growthlayer/gt-trackball/harness/gt-trackball.png

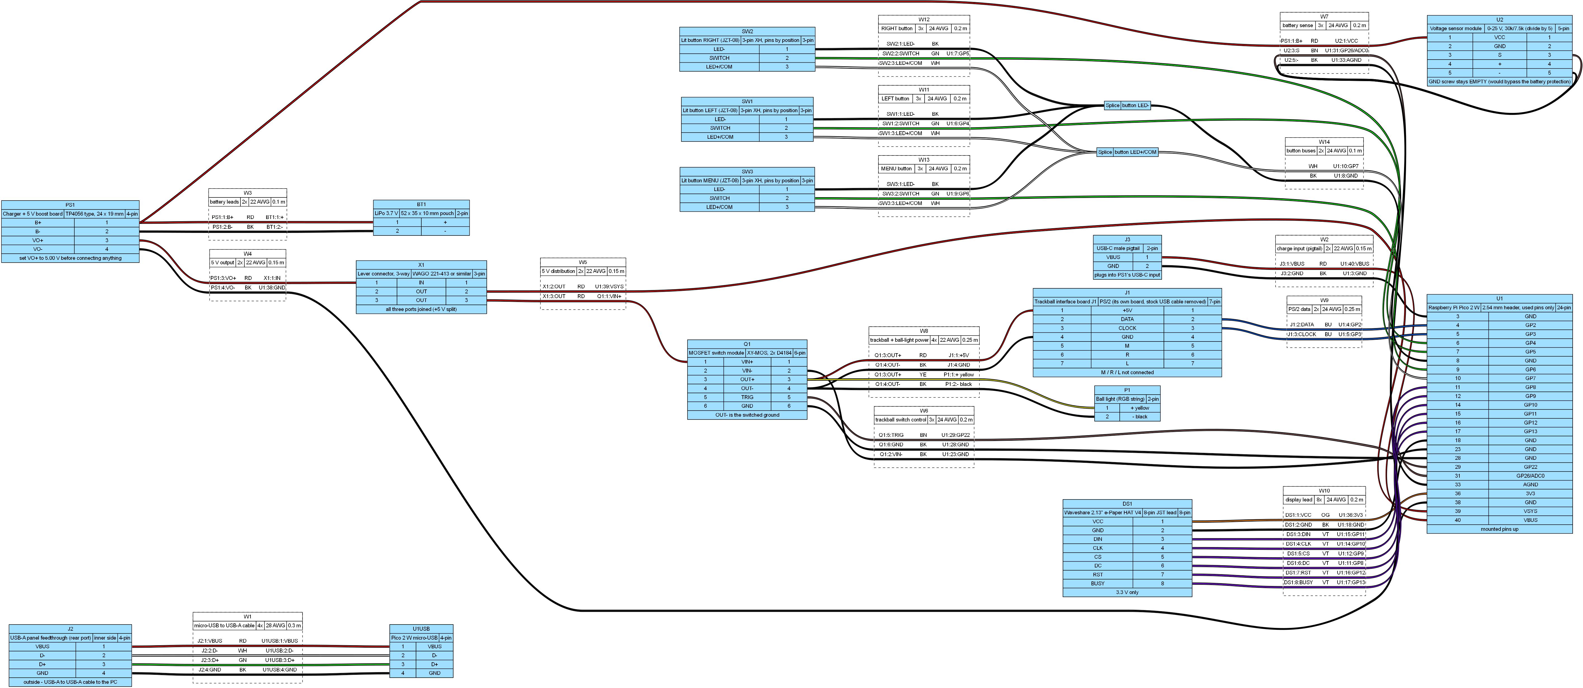
harness/gt-trackball.png
