growthlayer/gt-trackball/images/part_plate.png

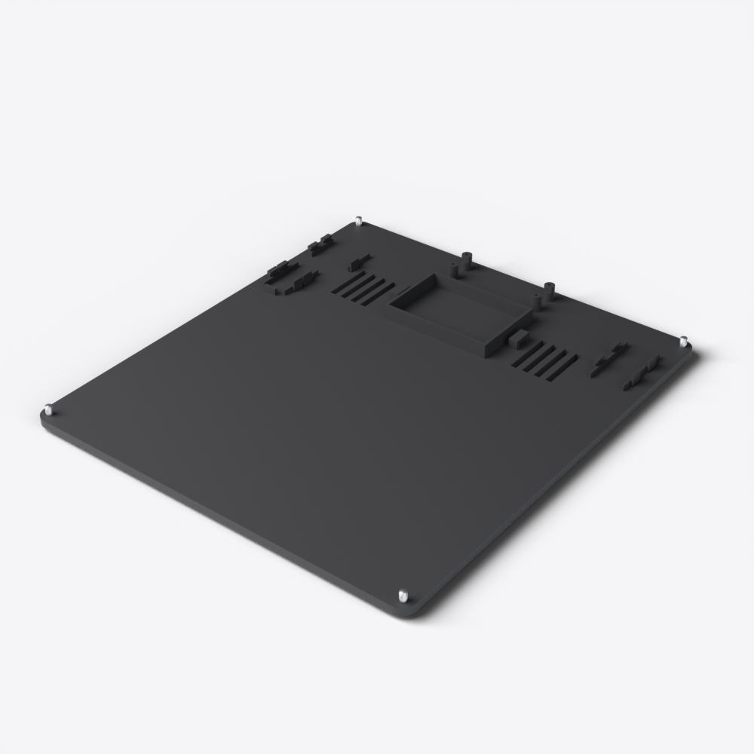
images/part_plate.png
