growthlayer/gt-trackball/images/part_shell.png

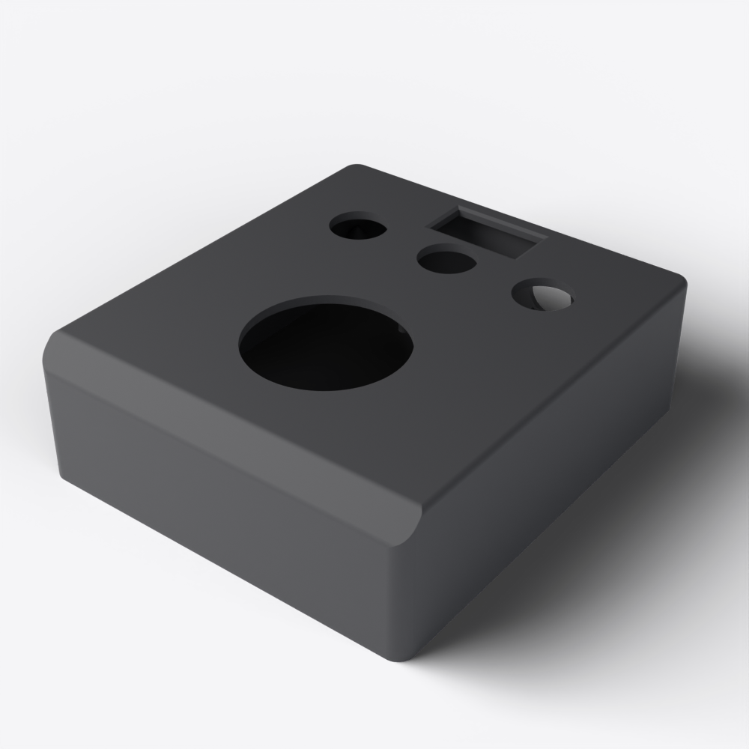
images/part_shell.png
