growthlayer/gt-trackball/print/bambu-a1/clips.3mf

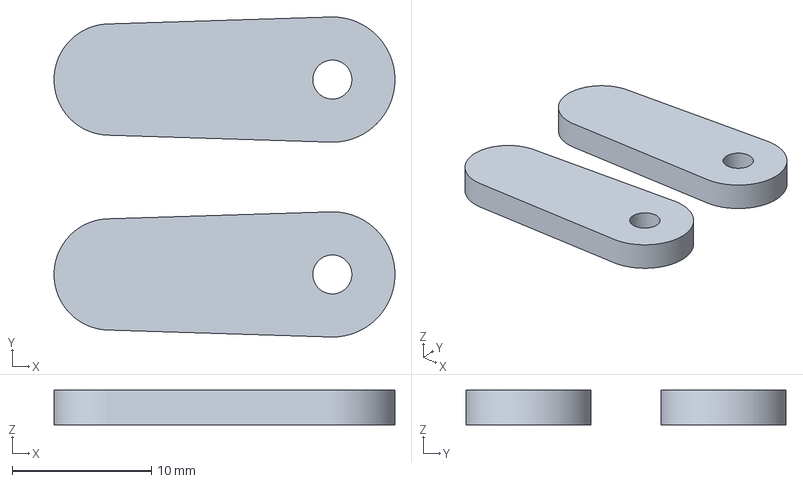
[picture p25: CAD file, 2026-10-12]
print/bambu-a1/clips.3mf
24.5 x 23.0 x 2.50 mm
