growthlayer/gt-trackball/print/bambu-p1s/gt-trackball-all.3mf

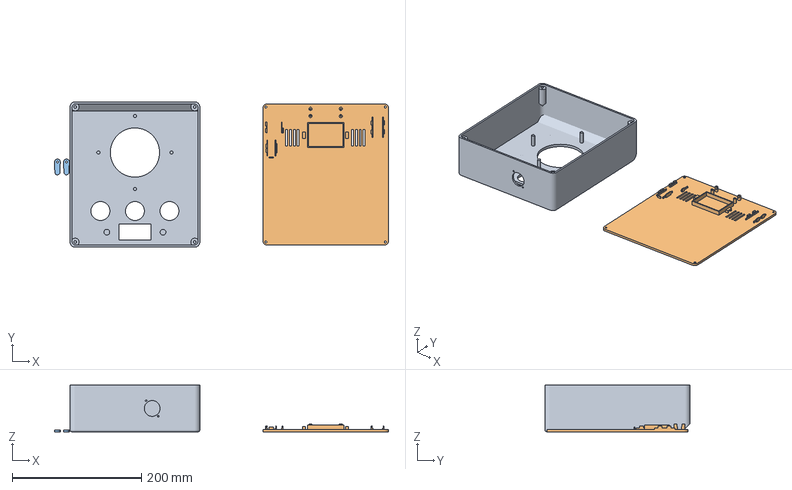
[picture p26: CAD file, 2026-10-12]
print/bambu-p1s/gt-trackball-all.3mf
516.9 x 225.0 x 72.1 mm
top.stl
bottom.stl
clips.stl
