growthlayer/gt-trackball/print/stl/bottom.stl

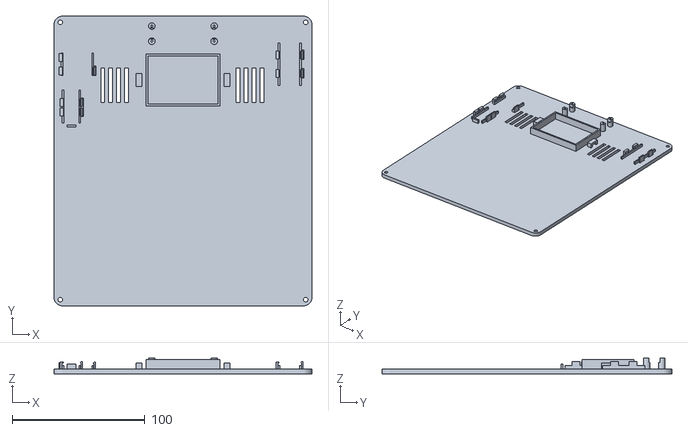
[picture p27: CAD file, 2026-10-12]
print/stl/bottom.stl
194.5 x 218.5 x 11.7
