growthlayer/gt-trackball/print/bambu-a1/top.3mf

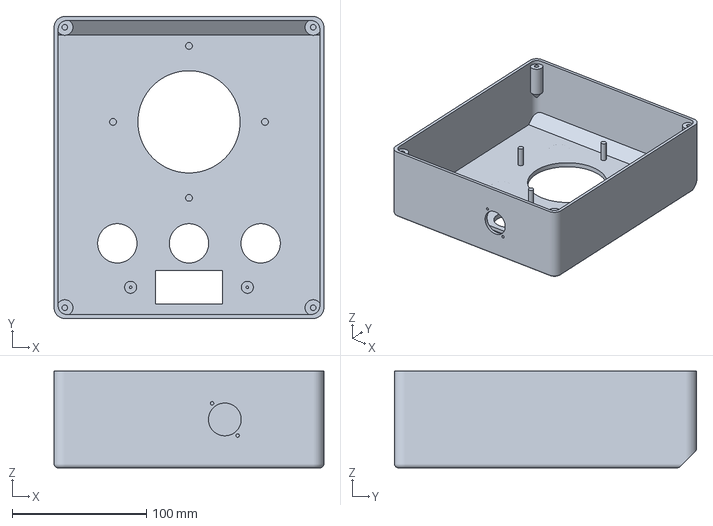
[picture p28: CAD file, 2026-10-12]
print/bambu-a1/top.3mf
201.0 x 225.0 x 72.1 mm
