growthlayer/gt-trackball/print/stl/mounts_test.stl

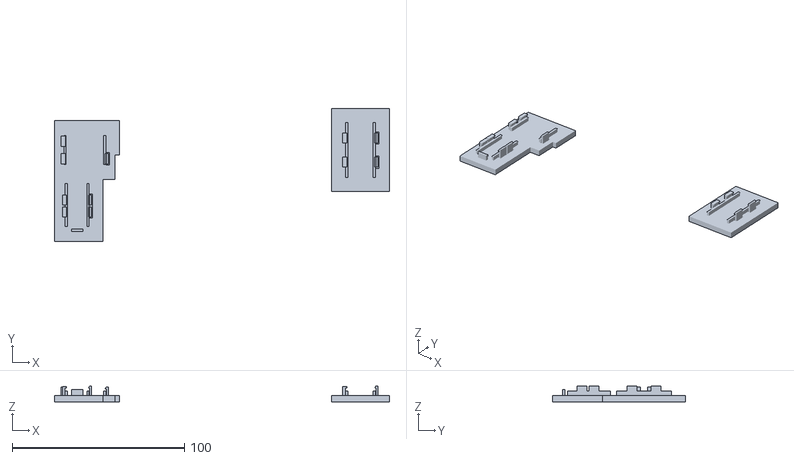
[picture p29: CAD file, 2026-10-12]
print/stl/mounts_test.stl
194.5 x 77.0 x 9.15
