growthlayer/gt-trackball/print/bambu-a1/mounts_test.3mf

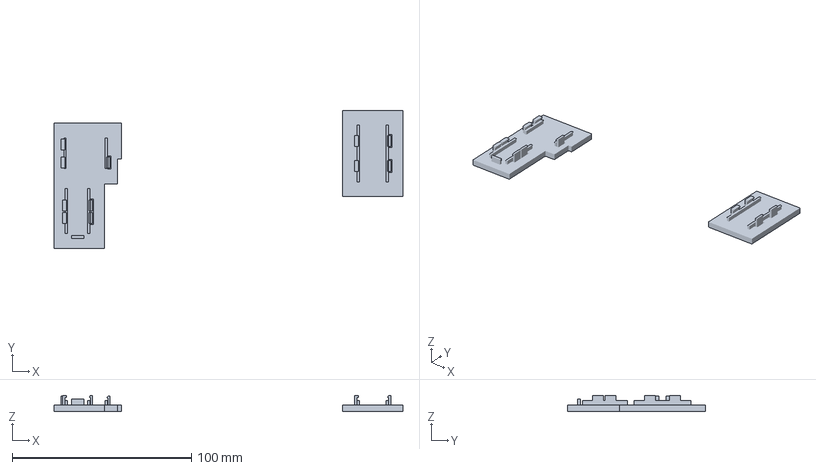
[picture p30: CAD file, 2026-10-12]
print/bambu-a1/mounts_test.3mf
194.5 x 77.0 x 9.15 mm
