growthlayer/gt-trackball/print/bambu-a1/gt-trackball-all.3mf

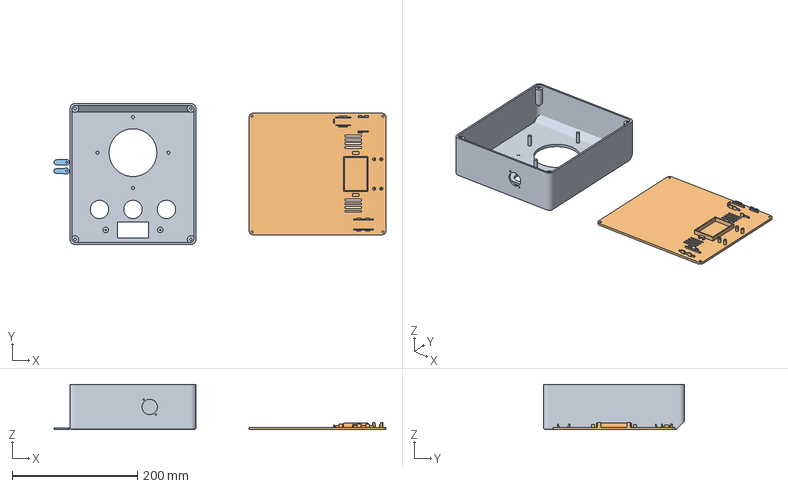
[picture p31: CAD file, 2026-10-12]
print/bambu-a1/gt-trackball-all.3mf
529.7 x 225.0 x 72.1 mm
top.stl
bottom.stl
clips.stl
