growthlayer/gt-trackball/(list of files, cad)

Other CAD files:
print/bambu-x1c/gt-trackball-all.3mf
print/bambu-p1s/bottom.3mf
print/bambu-x1c/bottom.3mf
print/bambu-a1/bottom.3mf
print/bambu-p1s/top.3mf
print/bambu-x1c/clips.3mf
print/stl/top.stl
print/bambu-p1s/clips.3mf
print/bambu-x1c/mounts_test.3mf
print/stl/clips.stl
print/bambu-p1s/mounts_test.3mf
print/bambu-x1c/top.3mf
