growthlayer/gt-trackball/kicad/gt-trackball.kicad_sch

## KiCad design kicad/gt-trackball.kicad_sch (2026-10-12)

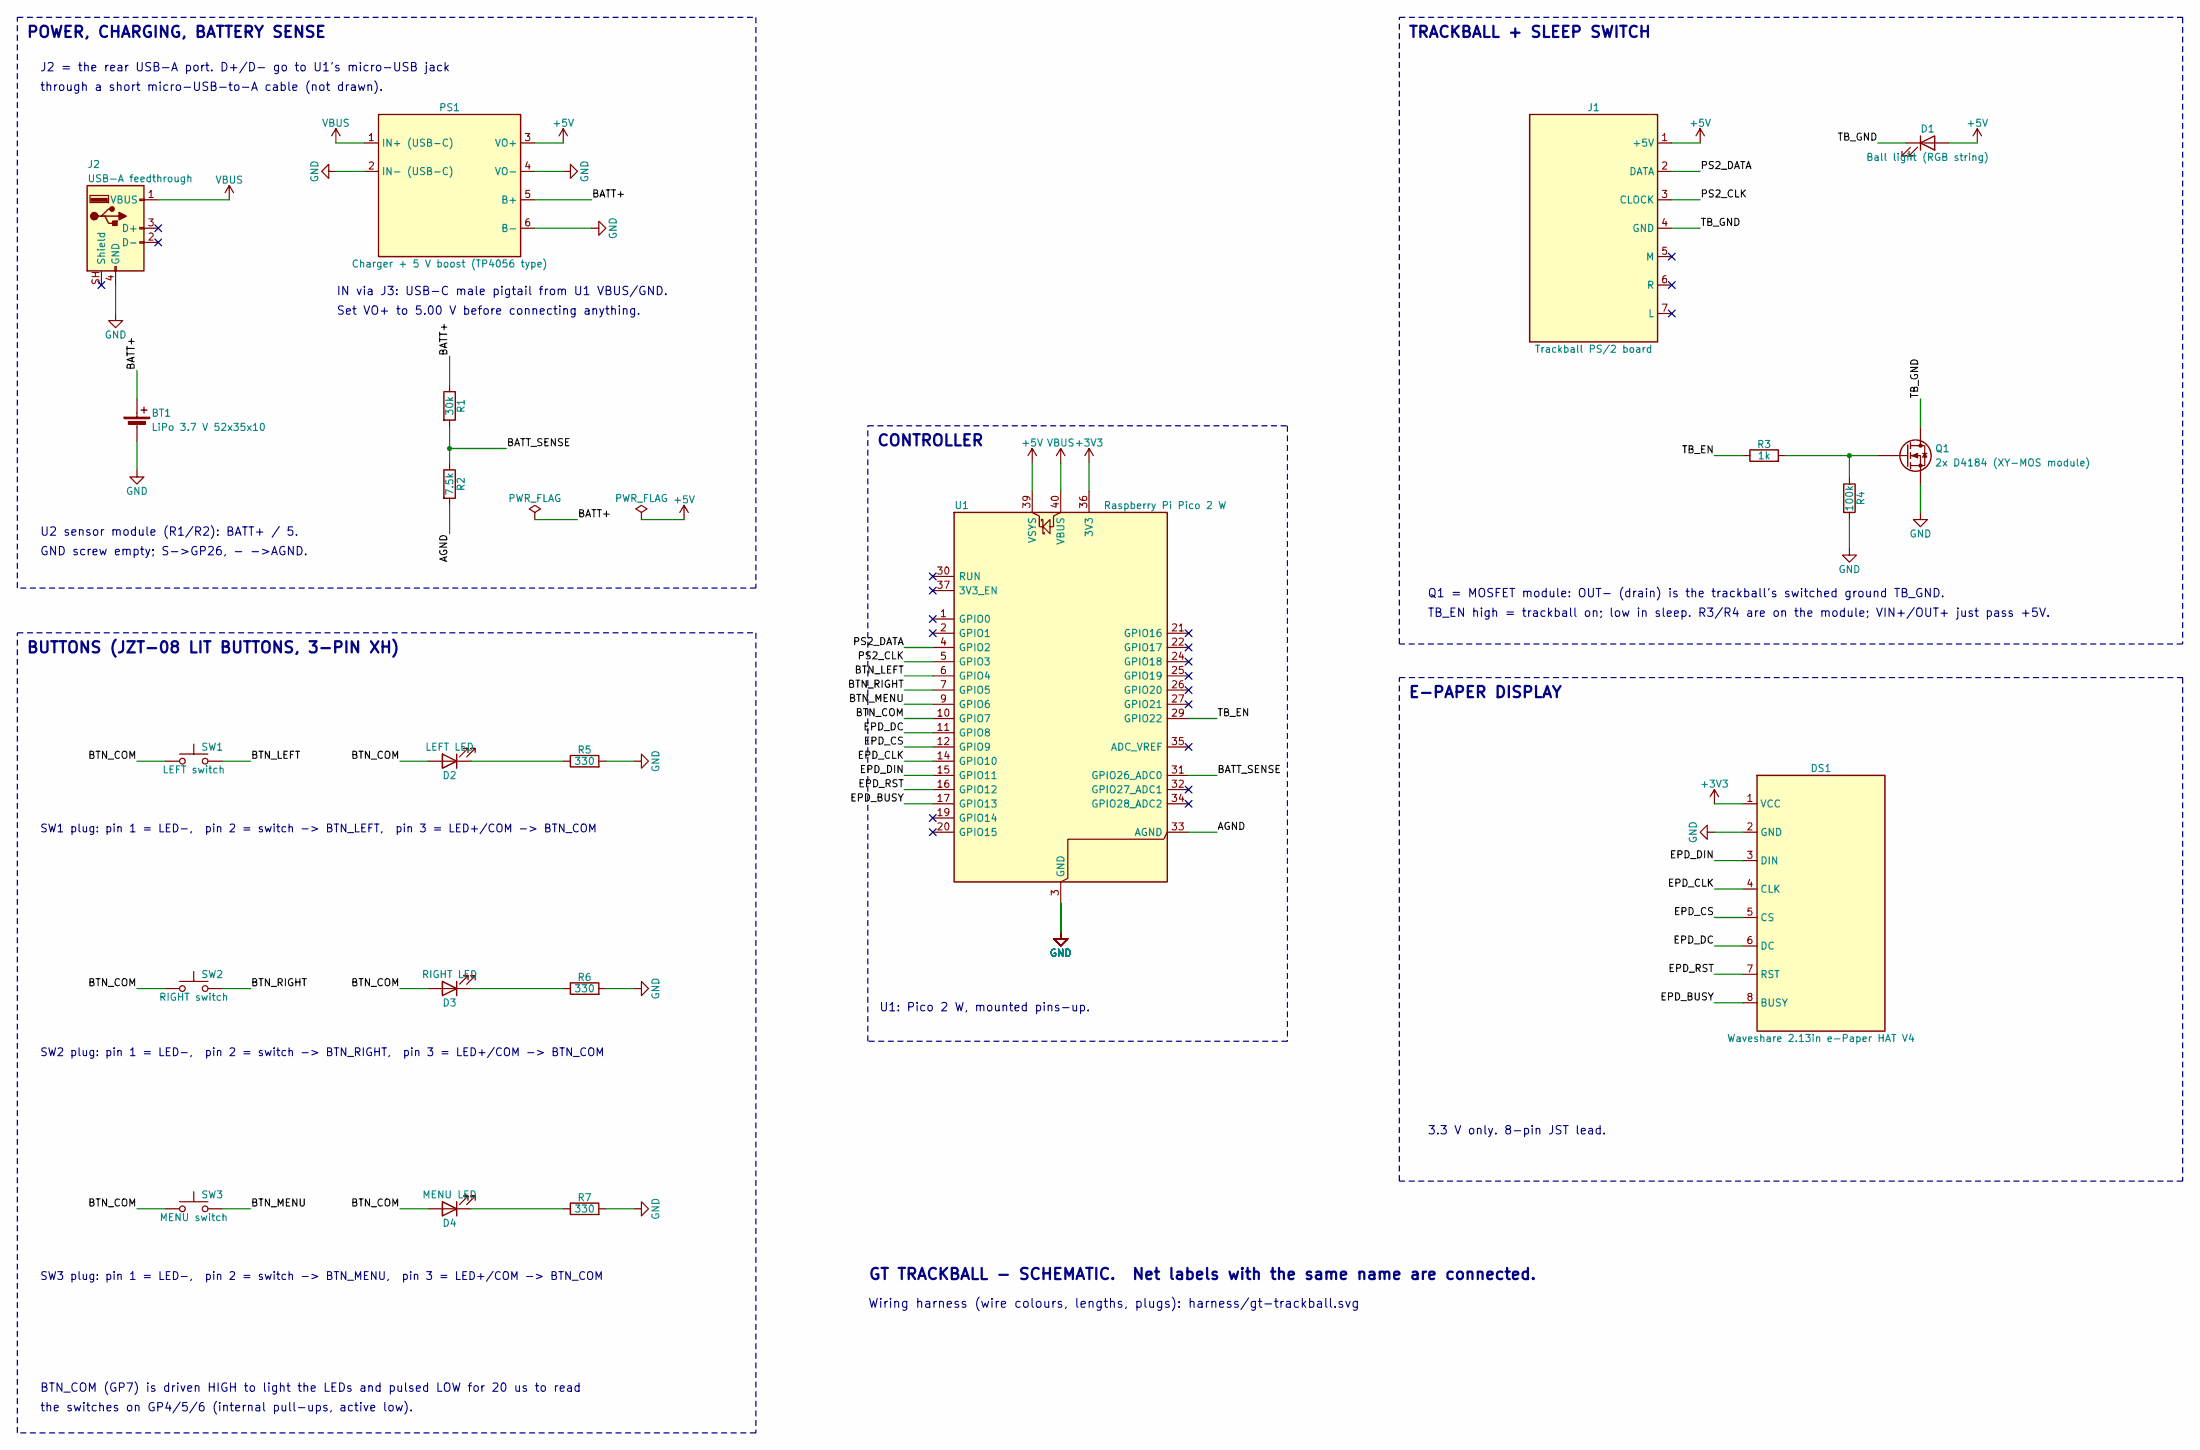
[picture p33: schematic gt-trackball.kicad_sch]

Parts:
BT1: LiPo 3.7 V 52x35x10
D1: Ball light (RGB string)
D2: LEFT LED
D3: RIGHT LED
D4: MENU LED
DS1: Waveshare 2.13in e-Paper HAT V4
J1: Trackball PS/2 board
J2: USB-A feedthrough
PS1: Charger + 5 V boost (TP4056 type)
Q1: 2x D4184 (XY-MOS module)
R1: 30k
R2: 7.5k
R3: 1k
R4: 100k
R5, R6, R7: 330
SW1: LEFT switch
SW2: RIGHT switch
SW3: MENU switch
U1: Raspberry Pi Pico 2 W

Connections:
+3V3: DS1.1 (VCC), U1.36 (3V3)
+5V: BT1.1 (+), D1.2 (A), J1.1 (+5V), PS1.3 (VO+), PS1.5 (B+), R1.1, U1.39 (VSYS)
AGND: R2.2, U1.33 (AGND)
BATT_SENSE: R1.2, R2.1, U1.31 (GPIO26_ADC0)
BTN_COM: D2.2 (A), D3.2 (A), D4.2 (A), SW1.1, SW2.1, SW3.1, U1.10 (GPIO7)
BTN_LEFT: SW1.2, U1.6 (GPIO4)
BTN_MENU: SW3.2, U1.9 (GPIO6)
BTN_RIGHT: SW2.2, U1.7 (GPIO5)
EPD_BUSY: DS1.8 (BUSY), U1.17 (GPIO13)
EPD_CLK: DS1.4 (CLK), U1.14 (GPIO10)
EPD_CS: DS1.5 (CS), U1.12 (GPIO9)
EPD_DC: DS1.6 (DC), U1.11 (GPIO8)
EPD_DIN: DS1.3 (DIN), U1.15 (GPIO11)
EPD_RST: DS1.7 (RST), U1.16 (GPIO12)
GND: BT1.2 (-), DS1.2 (GND), J2.4 (GND), PS1.2 (IN- (USB-C)), PS1.4 (VO-), PS1.6 (B-), Q1.S, R4.2, R5.2, R6.2, R7.2, U1.3 (GND), U1.8 (GND), U1.13 (GND), U1.18 (GND), U1.23 (GND), U1.28 (GND), U1.38 (GND)
unnamed: D2.1 (K), R5.1
unnamed: D3.1 (K), R6.1
unnamed: D4.1 (K), R7.1
unnamed: Q1.G, R3.2, R4.1
PS2_CLK: J1.3 (CLOCK), U1.5 (GPIO3)
PS2_DATA: J1.2 (DATA), U1.4 (GPIO2)
TB_EN: R3.1, U1.29 (GPIO22)
TB_GND: D1.1 (K), J1.4 (GND), Q1.D
VBUS: J2.1 (VBUS), PS1.1 (IN+ (USB-C)), U1.40 (VBUS)

Notes on the sheet:
CONTROLLER
U1: Pico 2 W, mounted pins-up.
POWER, CHARGING, BATTERY SENSE
J2 = the rear USB-A port. D+/D- go to U1's micro-USB jack
through a short micro-USB-to-A cable (not drawn).
IN via J3: USB-C male pigtail from U1 VBUS/GND.
Set VO+ to 5.00 V before connecting anything.
U2 sensor module (R1/R2): BATT+ / 5.
GND screw empty; S->GP26, - ->AGND.
TRACKBALL + SLEEP SWITCH
Q1 = MOSFET module: OUT- (drain) is the trackball's switched ground TB_GND.
TB_EN high = trackball on; low in sleep. R3/R4 are on the module; VIN+/OUT+ just pass +5V.
BUTTONS (JZT-08 LIT BUTTONS, 3-PIN XH)
SW1 plug: pin 1 = LED-, pin 2 = switch -> BTN_LEFT, pin 3 = LED+/COM -> BTN_COM
SW2 plug: pin 1 = LED-, pin 2 = switch -> BTN_RIGHT, pin 3 = LED+/COM -> BTN_COM
SW3 plug: pin 1 = LED-, pin 2 = switch -> BTN_MENU, pin 3 = LED+/COM -> BTN_COM
BTN_COM (GP7) is driven HIGH to light the LEDs and pulsed LOW for 20 us to read
the switches on GP4/5/6 (internal pull-ups, active low).
E-PAPER DISPLAY
3.3 V only. 8-pin JST lead.
GT TRACKBALL - SCHEMATIC. Net labels with the same name are connected.
Wiring harness (wire colours, lengths, plugs): harness/gt-trackball.svg
