growthlayer/gt-trackball/(commit log)

2026-10-11 GT Trackball v1.0
    Wireless 3in arcade trackball for Golden Tee: 3D-printed case, Pico 2 W firmware (Bluetooth + USB), e-paper swing meter, build guide.
    [bottom.stl, clips.stl, gt-trackball-case.3mf, top.stl, trackball_bt_case.scad]
2026-10-11 Accurate component renders (exploded, cutaway, per-part), trackball modelled from photos, pictorial step-by-step wiring diagrams, per-printer print files (X1C/P1S/A1, all-in-one + per part)
    [bottom.3mf, bottom.stl, clips.3mf, clips.stl, gt-trackball-all.3mf, gt-trackball-case.3mf, top.3mf, top.stl]
2026-10-12 Add KiCad schematic and WireViz harness drawings
    - kicad/: generated KiCad 10 schematic (ERC clean), project symbol
    library, PDF and SVG; tools/make_kicad_schematic.py rebuilds it
    - harness/: WireViz source with wire colours, gauges, lengths and BOM
    - README step 3.5 links both; repository layout updated
    [gt-trackball.bom.tsv, gt-trackball.kicad_sch]
2026-10-12 Redraw the pictorial wiring diagrams with grid-routed wires
    - wires run straight with square corners on a fixed grid, never on top
    of each other; a bridge marks a crossing, a dot marks a join
    - right-hand modules lined up with their Pico pins so most power,
    sense and switch wires are straight runs
    - grounds swapped for a cleaner route: USB-C pigtail black -> GND (3),
    MOSFET VIN- -> GND (23) (all GND pins are common); harness updated
    - schematic/harness kept as reference links instead of README images
    [gt-trackball.yml]
2026-10-12 Wiring diagrams: add a pin-to-pin connection chart beside each picture
2026-10-12 Renders: remodel the trackball from the seller photos (no side wings)
    Square clipped top plate, boxy body, two short encoder housings with their
    sensor boards on adjacent sides, copper LED tabs. All renders refreshed.
2026-10-12 Bottom plate: snap-in cradles for the charger, MOSFET and voltage sensor
    - replaces the loose pegs / hot glue: boards sit 2.5 mm up on edge rails,
    fixed lips on one side, a flexing hook (in a relief moat) on the other
    - MOSFET cradle sized for the real 34 x 17 XY-MOS board (pegs were 30)
    - sensor cradle has one end stop only, so board lengths may vary
    - new optional mounts_test part + 3MFs; all print files rebuilt
    - docs: snap-in assembly step, stale "long arms" line removed, honest
    note on Bambu's floating-regions notice for the top shell
    - renders refreshed
    [bottom.3mf, bottom.stl, clips.3mf, gt-trackball-all.3mf, mounts_test.3mf, mounts_test.stl, top.3mf, trackball_bt_case.scad]
2026-10-12 Overview diagram: part pictures, no crossing wires, legend, power arrows
    New generator tools/make_overview.py replaces the hand-made overview.
2026-10-12 Firmware: Bluetooth self-repair + persistent BLE log; repo synced to device
    - hid_mouse: "connected" now means an encrypted link; if a reconnect
    isn't encrypted within ~5 s the controller hangs up so the host retries
    (Windows ignores HID reports on an unencrypted link while showing a link)
    - blelog.py: last 60 BLE events (boot, connect, encryption, disconnect)
    in ble_log.txt on the Pico -> mpremote cat :ble_log.txt
    - main.py: now matches what was running on the controller (soft restart
    on wake / mode switch, made on the Mac and never committed) plus the
    input/battery tweaks from 3a436d5 that had not reached the device
2026-10-12 Firmware: advertise fast (30 ms) for the first 30 s after a restart
    Windows took 26-29 s to reconnect while the controller advertised every
    250 ms; falls back to 250 ms after 30 s to save battery.
2026-10-12 Firmware: hard reset on wake and on cable unplug (fresh radio chip)
    After a soft restart from a session where Bluetooth had been running, the
    CYW43 radio kept stale state and Windows could never re-encrypt the link
    (BLE log: pair TimeoutError on every reconnect after a soft restart, fine
    after every hard reset). Soft restart is kept for cable plug-in, where a
    hard reset left USB dead.
    [main.py]
